admyren/touch_filter/Project/Hardware/pcb/assembly/codec_breakot_bom.csv

Comment | Designator | Footprint | LCSC
2.2u | C1 | Capacitors_SMD:C_0603 | C23630
10u | C10,C13,C17,C33,C34,C35 | Capacitors_SMD:C_0805 | C15850
1u | C2,C4,C21,C22 | Capacitors_SMD:C_0603 | C15849
22u | C7,C9,C24,C25 | Capacitors_SMD:C_0805 | C45783
4.7u | C26,C27 | Capacitors_SMD:C_0603 | C19666
12p | C28,C30 | Capacitors_SMD:C_0402 | C1547
100n | C3,C5,C6,C11,C12,C14,C15,C16,C18,C19,C20,C23,C29,C31,C32 | Capacitors_SMD:C_0603 | C14663
2.2n | C8 | Capacitors_SMD:C_0402 | C1531
B5819W | D3,D4 | Diodes_SMD:D_SOD-123 | C8598
C72043 | D1,D2,D5 | LEDs:LED_0603 | C72043
500 mA | F1 | Fuse_Holders_and_Fuses:Fuse_SMD1206_HandSoldering
100 @ 100 MHz | FB3 | Inductor_SMD:L_0805_2012Metric
16MHz | HSE1 | Crystals:Crystal_SMD_3225-4pin_3.2x2.5mm | C13738
Conn_01x04 | J1 | Pin_Headers:Pin_Header_Straight_1x04_Pitch2.54mm
Conn | J2 | Pin_Headers:Pin_Header_Straight_2x02_Pitch2.54mm
Conn_01x04 | J3 | egna_footprints:conn_pad_SMD_1x4_1mm
Screw_Terminal_01x02 | J4 | Pin_Headers:Pin_Header_Straight_1x02_Pitch2.54mm
USB_B_Micro | J5 | egna_footprints:USB_micro_smd
Conn_02x05_Odd_Even | J6 | Pin_Headers:Pin_Header_Straight_2x05_Pitch2.54mm
AudioJack3_Ground | J7,J8 | Connector_Audio:Jack_3.5mm_CUI_SJ-3523-SMT_Horizontal
Conn_01x04 | J9 | Pin_Headers:Pin_Header_Straight_1x04_Pitch1.27mm
SDCL1005C39NJTDF | L1,L2 | Inductor_SMD:L_0402_1005Metric | C26443
10k | R1,R2 | Resistors_SMD:R_0402 | C25744
220 | R10 | Resistors_SMD:R_0603 | C22962
2k2 | R3,R4,R5,R6,R7,R8,R9 | Resistors_SMD:R_0402 | C25879
MPU-6050 | U1 | egna_footprints:QFN-24_4x4_Pitch0.5mm | C24112
STM32F405RGT6 | U2 | Housings_QFP:LQFP-64_10x10mm_Pitch0.5mm | C15742
AMS1117-3.3 | U3 | TO_SOT_Packages_SMD:SOT-223-3_TabPin2 | C6186
WM8960 | U4 | Housings_DFN_QFN:QFN-32-1EP_5x5mm_Pitch0.5mm | C18752
USBLC6-2SC6 | U5 | TO_SOT_Packages_SMD:SOT-23-6 | C7519
