admyren/touch_filter/Project/Hardware/pcb/codec_breakot.kicad_pcb

## KiCad design Project/Hardware/pcb/codec_breakot.kicad_pcb (2021-05-31)

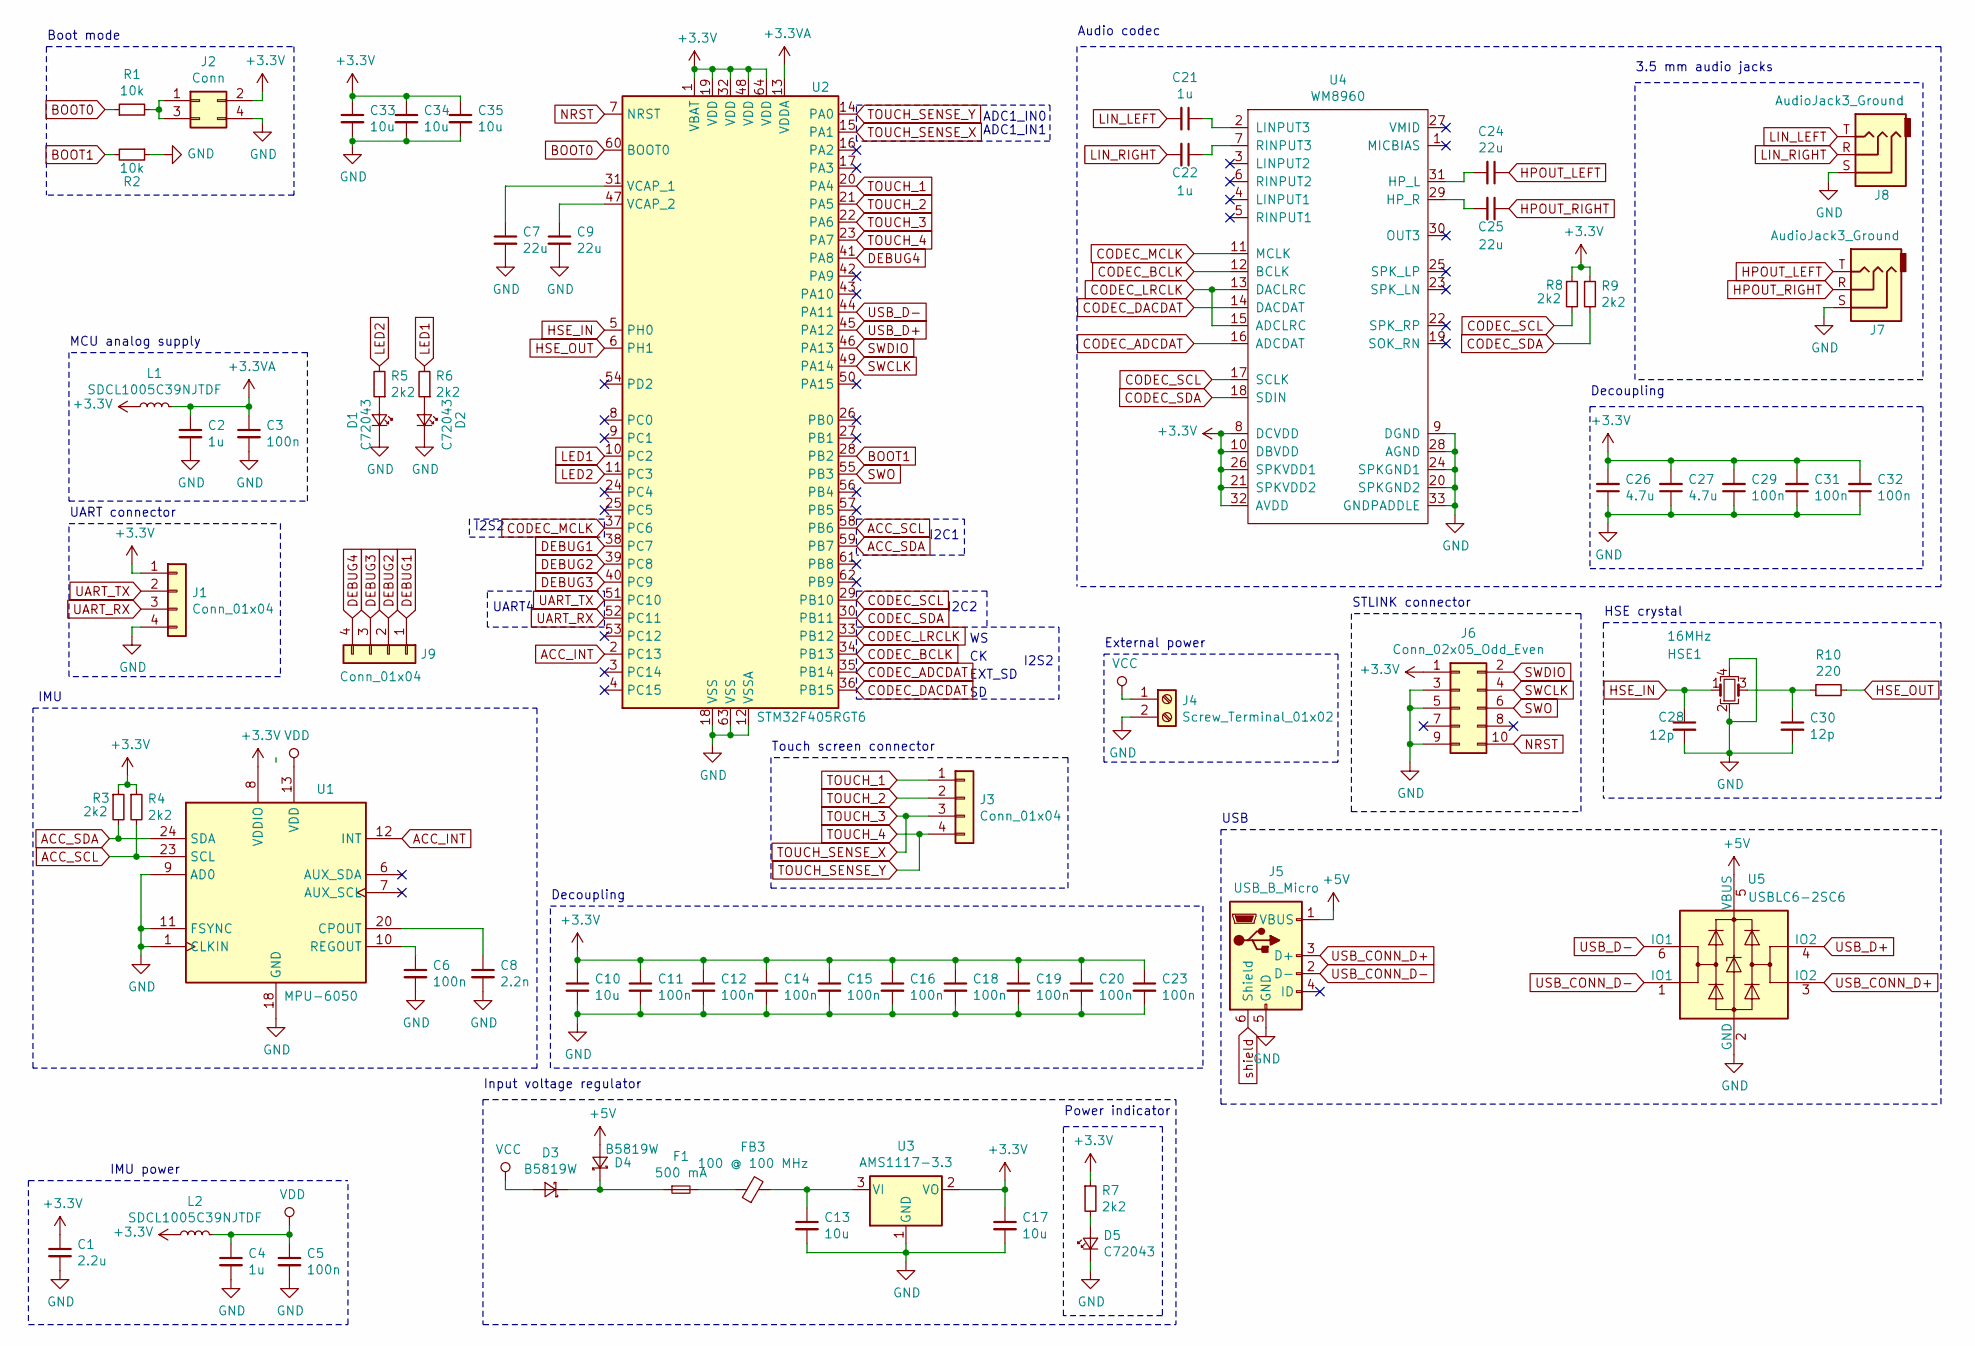
[picture p1: schematic codec_breakot.sch]

Parts:
C1: 2.2u; C_0603; LCSC Part # C23630
C2, C4, C21, C22: 1u; C_0603; LCSC Part # C15849
C3, C5, C6, C11, C12, C14, C15, C16, C18, C19, C20, C23, C29, C31, C32: 100n; C_0603; LCSC Part # C14663
C7, C9, C24, C25: 22u; C_0805; LCSC Part # C45783
C8: 2.2n; C_0402; LCSC Part # C1531
C10, C13, C17, C33, C34, C35: 10u; C_0805; LCSC Part # C15850
C26, C27: 4.7u; C_0603; LCSC Part # C19666
C28, C30: 12p; C_0402; LCSC Part # C1547
D1, D2, D5: C72043; LED_0603; LCSC Part # C72043
D3, D4: B5819W; D_SOD-123; LCSC Part # C8598
F1: 500 mA; Fuse_SMD1206_HandSoldering
FB3: 100 @ 100 MHz; L_0805_2012Metric
HSE1: 16MHz; Crystal_SMD_3225-4pin_3.2x2.5mm; LCSC Part # C13738
J1: Conn_01x04; Pin_Header_Straight_1x04_Pitch2.54mm
J2: Conn; Pin_Header_Straight_2x02_Pitch2.54mm
J3: Conn_01x04; conn_pad_SMD_1x4_1mm
J4: Screw_Terminal_01x02; Pin_Header_Straight_1x02_Pitch2.54mm
J5: USB_B_Micro; USB_micro_smd
J6: Conn_02x05_Odd_Even; Pin_Header_Straight_2x05_Pitch2.54mm
J7, J8: AudioJack3_Ground; Jack_3.5mm_CUI_SJ-3523-SMT_Horizontal
J9: Conn_01x04; Pin_Header_Straight_1x04_Pitch1.27mm
L1, L2: SDCL1005C39NJTDF; L_0402_1005Metric; LCSC Part # C26443
R1, R2: 10k; R_0402; LCSC Part # C25744
R3, R4, R5, R6, R7, R8, R9: 2k2; R_0402; LCSC Part # C25879
R10: 220; R_0603; LCSC Part # C22962
U1: MPU-6050; QFN-24_4x4_Pitch0.5mm; LCSC Part # C24112
U2: STM32F405RGT6; LQFP-64_10x10mm_Pitch0.5mm; LCSC Part # C15742
U3: AMS1117-3.3; SOT-223-3_TabPin2; LCSC Part # C6186
U4: WM8960; QFN-32-1EP_5x5mm_Pitch0.5mm; LCSC Part # C18752
U5: USBLC6-2SC6; SOT-23-6; LCSC Part # C7519

Connections:
+3.3VA: C2.1, C3.1, L1.2, U2.13 (VDDA)
+3V3: C1.1, C10.1, C11.1, C12.1, C14.1, C15.1, C16.1, C17.1, C18.1, C19.1, C20.1, C23.1, C26.2, C27.2, C29.2, C31.2, C32.2, C33.1, C34.1, C35.1, J1.1, J2.2, J6.1, L1.1, L2.1, R3.1, R4.1, R7.1, R8.1, R9.1, U1.8 (VDDIO), U2.1 (VBAT), U2.19 (VDD), U2.32 (VDD), U2.48 (VDD), U2.64 (VDD), U3.2 (VO), U4.8 (DCVDD), U4.10 (DBVDD), U4.21 (SPKVDD2), U4.26 (SPKVDD1), U4.32 (AVDD)
+5V: D4.2 (A), J5.1 (VBUS), U5.5 (VBUS)
ACC_INT: U1.12 (INT), U2.2 (PC13)
ACC_SCL: R4.2, U1.23 (SCL), U2.58 (PB6)
ACC_SDA: R3.2, U1.24 (SDA), U2.59 (PB7)
BOOT0: R1.1, U2.60 (BOOT0)
BOOT1: R2.2, U2.28 (PB2)
CODEC_ADCDAT: U2.35 (PB14), U4.16 (ADCDAT)
CODEC_BCLK: U2.34 (PB13), U4.12 (BCLK)
CODEC_DACDAT: U2.36 (PB15), U4.14 (DACDAT)
CODEC_LRCLK: U2.33 (PB12), U4.13 (DACLRC), U4.15 (ADCLRC)
CODEC_MCLK: U2.37 (PC6), U4.11 (MCLK)
CODEC_SCL: R8.2, U2.29 (PB10), U4.17 (SCLK)
CODEC_SDA: R9.2, U2.30 (PB11), U4.18 (SDIN)
DEBUG1: J9.1, U2.38 (PC7)
DEBUG2: J9.2, U2.39 (PC8)
DEBUG3: J9.3, U2.40 (PC9)
DEBUG4: J9.4, U2.41 (PA8)
GND: C1.2, C2.2, C3.2, C4.2, C5.2, C6.2, C7.2, C8.2, C9.2, C10.2, C11.2, C12.2, C13.2, C14.2, C15.2, C16.2, C17.2, C18.2, C19.2, C20.2, C23.2, C26.1, C27.1, C28.2, C29.1, C30.2, C31.1, C32.1, C33.2, C34.2, C35.2, D1.1 (K), D2.1 (K), D5.1 (K), HSE1.2, HSE1.4, J1.4, J2.4, J4.2, J5.5 (GND), J6.3, J6.5, J6.9, J7.S, J8.S, R2.1, U1.1 (CLKIN), U1.9 (AD0), U1.11 (FSYNC), U1.18 (GND), U2.12 (VSSA), U2.18 (VSS), U2.63 (VSS), U3.1 (GND), U4.9 (DGND), U4.20 (SPKGND2), U4.24 (SPKGND1), U4.28 (AGND), U4.33 (GNDPADDLE), U5.2 (GND)
HPOUT_LEFT: C24.1, J7.T
HPOUT_RIGHT: C25.1, J7.R
HSE_IN: C28.1, HSE1.1, U2.5 (PH0)
HSE_OUT: R10.2, U2.6 (PH1)
LED1: R6.2, U2.10 (PC2)
LED2: R5.2, U2.11 (PC3)
LIN_LEFT: C21.2, J8.T
LIN_RIGHT: C22.2, J8.R
NRST: J6.10, U2.7 (NRST)
unnamed: C6.1, U1.10 (REGOUT)
unnamed: C7.1, U2.31 (VCAP_1)
unnamed: C8.1, U1.20 (CPOUT)
unnamed: C9.1, U2.47 (VCAP_2)
unnamed: C13.1, FB3.2, U3.3 (VI)
unnamed: C21.1, U4.2 (LINPUT3)
unnamed: C22.1, U4.7 (RINPUT3)
unnamed: C24.2, U4.31 (HP_L)
unnamed: C25.2, U4.29 (HP_R)
unnamed: C30.1, HSE1.3, R10.1
unnamed: D1.2 (A), R5.1
unnamed: D2.2 (A), R6.1
unnamed: D3.1 (K), D4.1 (K), F1.1
unnamed: D5.2 (A), R7.2
unnamed: F1.2, FB3.1
unnamed: J2.1, J2.3, R1.2
SWCLK: J6.4, U2.49 (PA14)
SWDIO: J6.2, U2.46 (PA13)
SWO: J6.6, U2.55 (PB3)
TOUCH_1: J3.1, U2.20 (PA4)
TOUCH_2: J3.2, U2.21 (PA5)
TOUCH_3: J3.3, U2.15 (PA1), U2.22 (PA6)
TOUCH_4: J3.4, U2.14 (PA0), U2.23 (PA7)
UART_RX: J1.3, U2.52 (PC11)
UART_TX: J1.2, U2.51 (PC10)
USB_CONN_D+: J5.3 (D+), U5.3 (IO2)
USB_CONN_D-: J5.2 (D-), U5.1 (IO1)
USB_D+: U2.45 (PA12), U5.4 (IO2)
USB_D-: U2.44 (PA11), U5.6 (IO1)
VCC: D3.2 (A), J4.1
VDD: C4.1, C5.1, L2.2, U1.13 (VDD)
shield: J5.6 (Shield)

Notes on the sheet:
Input voltage regulator
Power indicator
Decoupling
3.5 mm audio jacks
Audio codec
USB
STLINK connector
HSE crystal
Boot mode
MCU analog supply
IMU power
I2C2
I2S2
I2C1
UART4
ADC1_IN0
ADC1_IN1
IMU
Touch screen connector
UART connector
External power
EXT_SD

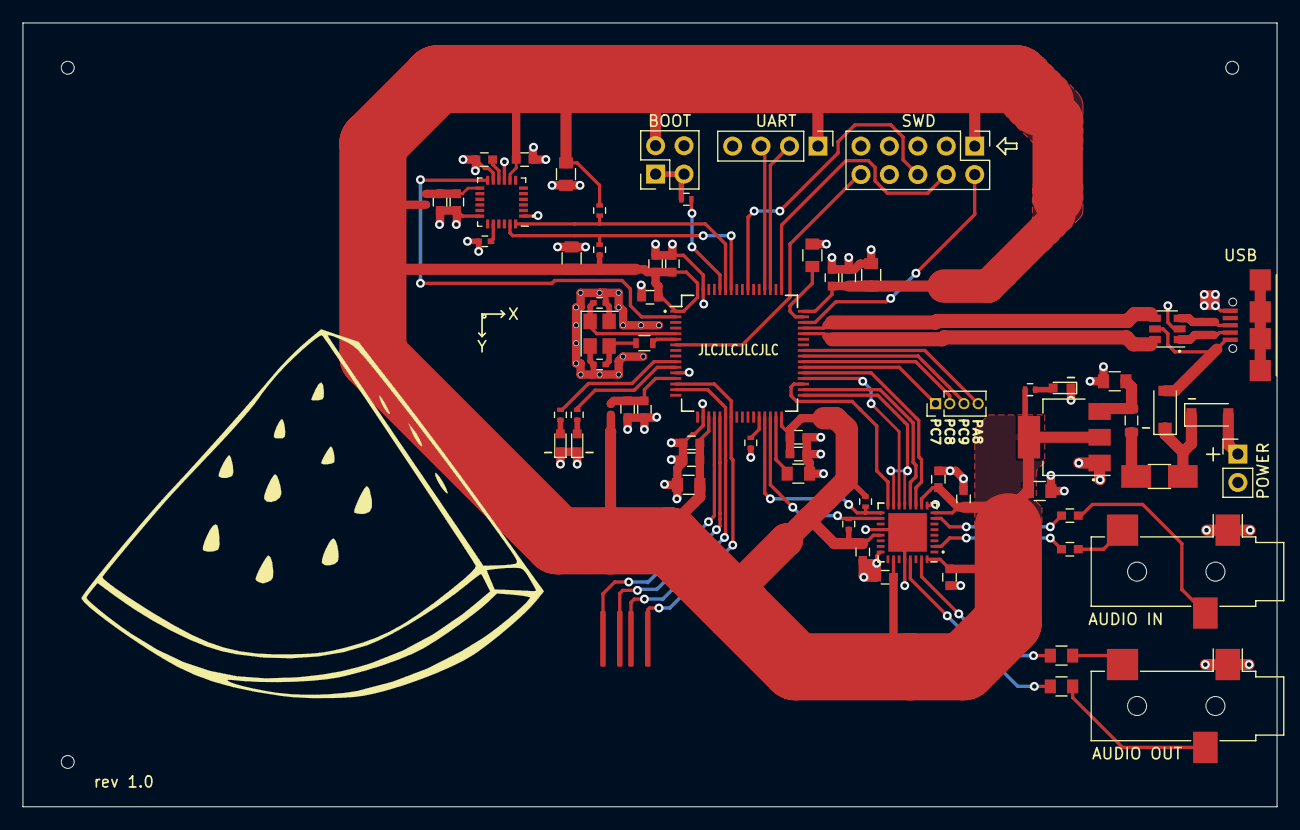
[picture p2: board codec_breakot.kicad_pcb from above]

Board: 2 copper layers, 112.0 x 70.0 mm, 72 parts (0 on the bottom side), 60 nets.

Other parts of the board:
TOOLING HOLE: jlcpcb_tooling_hole
TOOLING HOLE#2, TOOLING HOLE#3: jlcpcb_tooling_hole
