admyren/touch_filter/Project/Software/workspace/touch_filter/inc/stm32_peripherals.h

/*
 * stm32_peripherals.h
 *
 *  Created on: 28 aug. 2021
 *      Author: Myren
 */

#ifndef STM32_PERIPHERALS_H_
#define STM32_PERIPHERALS_H_

#define TIMEOUT_WAIT_COUNT 10000

#if 0
typedef enum
{
   GPIOA,
   GPIOB,
   GPIOC,
   GPIOD,
   GPIOE,
   GPIOF,
   GPIOG
};
#endif


#endif /* STM32_PERIPHERALS_H_ */
